jtqq2607229429/my_blancing_car/images/IMG_20210822_150952.jpg

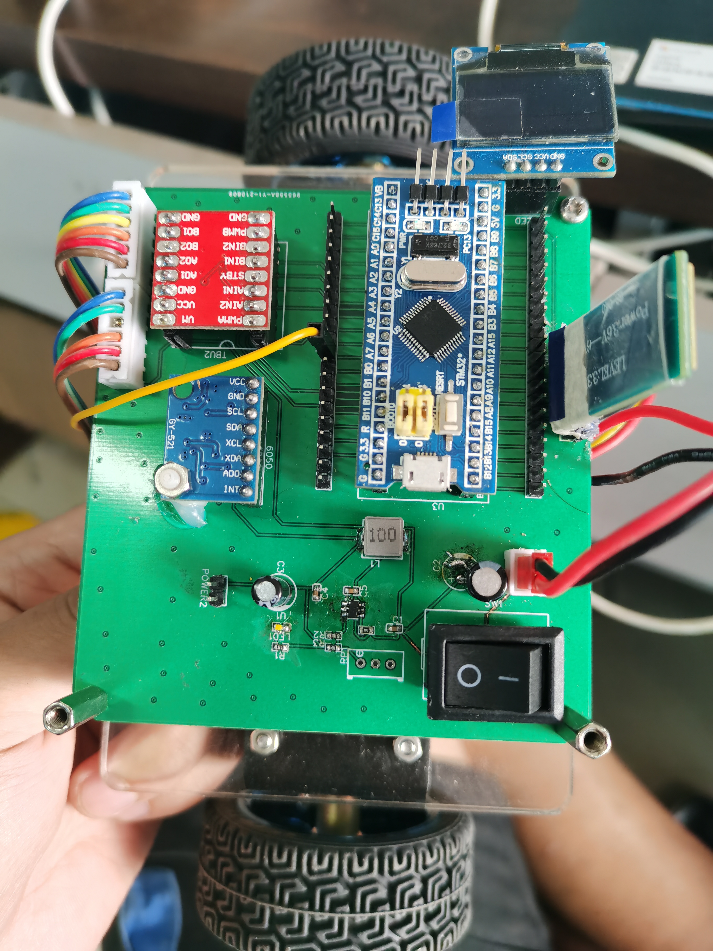
images/IMG_20210822_150952.jpg
