jtqq2607229429/my_blancing_car/Core/Src/main.c

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
/* Includes ------------------------------------------------------------------*/
#include "main.h"
#include "i2c.h"
#include "tim.h"
#include "usart.h"
#include "gpio.h"

/* USER CODE BEGIN Includes */
//#include "oled.h"
#include "hc05.h"
#include "math.h"
#include "mpu6050.h"
#include "oled.h"
#include "pid.h"
#include "stdbool.h"
/* USER CODE END Includes */

/* USER CODE BEGIN PTD */
float kP = 0, kI = 0, kD = 0;
float kP_p = 0, kI_p = 0, kD_p = 0;
float kP_t = 0, kI_t = 0, kD_t = 0;
bool start_flag = false;  //启动
int motor, dir1, dir2 = 0;
extern long rxIndex;
extern int out;
extern int t;
TxPack txpack;
RxPack rxpack;  //蓝牙使用结构体

/* USER CODE END PTD */


void SystemClock_Config(void);
/* USER CODE BEGIN 0 */
//int __io_putchar(int ch) {
//    uint8_t temp[1] = {ch};
//    HAL_UART_Transmit(&huart1, temp, 1, 0xff);
//    return (ch);
//}
/* USER CODE END 0 */

/**
  * @brief  The application entry point.
  * @retval int
  */
int main(void)
{
  /* MCU Configuration--------------------------------------------------------*/

  /* Reset of all peripherals, Initializes the Flash interface and the Systick. */
  HAL_Init();

  /* Configure the system clock */
  SystemClock_Config();

  /* Initialize all configured peripherals */
  MX_GPIO_Init();
  MX_TIM2_Init();
  MX_TIM3_Init();
  MX_USART1_UART_Init();
  MX_TIM4_Init();
  MX_I2C1_Init();
  MX_I2C2_Init();
  MX_TIM1_Init();
  /* USER CODE BEGIN 2 */

    OLED_Init();
    OLED_Clear();
    OLED_ShowString(0, 1, "hollo!", 12);
    OLED_ShowString(0, 2, "kP:", 12);
    OLED_ShowString(0, 3, "kD:", 12);
    OLED_ShowString(0, 4, "kI:", 12);

    HAL_TIM_PWM_Start(&htim2, TIM_CHANNEL_4);  //电机初始化
    HAL_TIM_PWM_Start(&htim2, TIM_CHANNEL_1);  //
    __HAL_TIM_SET_COMPARE(&htim2, TIM_CHANNEL_1, 0);
    __HAL_TIM_SET_COMPARE(&htim2, TIM_CHANNEL_4, 0);

    HAL_TIM_Encoder_Start(&htim3, TIM_CHANNEL_ALL);
    HAL_TIM_Encoder_Start(&htim4, TIM_CHANNEL_ALL);
    __HAL_TIM_SET_COUNTER(&htim3, 5000);
    __HAL_TIM_SET_COUNTER(&htim4, 5000);  // 编码器初始化

    PID_Init(&BC_A_PID, 420, 0, 1.2);
    PID_Init(&BC_P_PID, 550, 2.75, 1.1);                //pid初始化
    PID_Init(&BC_T_PID, -9, 0, -0.8);

    MPU6050_initialize();
    DMP_Init();                                                   //DMP6050初始化

    HAL_Delay(500);                                         //等待6050初始化

    HAL_UART_Receive_IT(&huart1, (uint8_t *) &uartByte, 1);  //蓝牙初始化

    HAL_Delay(200);

    HAL_TIM_Base_Start_IT(&htim1);
   //
  /* USER CODE END 2 */

  /* Infinite loop */
  /* USER CODE BEGIN WHILE */
#pragma clang diagnostic push
#pragma ide diagnostic ignored "EndlessLoop"
    while (1) {
        if (readValuePack(&rxpack)) {          //读蓝牙传输数据
            kP = (float) (rxpack.floats[0]);
            kI = (float) (rxpack.floats[1]);               //这个是第二个速度PID，kP值.
            kD = (float) (rxpack.floats[2]);               //获得pid设定值
            kP_p = (float)(rxpack.floats[3]);
            kD_p = (float) (rxpack.floats[5]);
            kI_p = (float) (rxpack.floats[4]);               //这个是第二个速度PID，kP值.
            kP_t = (float) (rxpack.floats[6]);               //获得pid设定值
            kD_t = (float)(rxpack.floats[8]);
            kI_t = (float)(rxpack.floats[7]);

            motor = rxpack.integers[0];                    //获得速度值
            dir1 = rxpack.integers[1];

            if (rxpack.bools[0]) {                            //将参数存入flash
                save();
            }
            if (rxpack.bytes[0]) {                            //启动
                start_flag = true;
                PID_Init(&BC_A_PID, kP, kI, kD);
                PID_Init(&BC_P_PID, kP_p*200, kP_p, kD);
                PID_Init(&BC_T_PID, kP_t, kI_t, kD_t);
            } else {
                start_flag = false;
            }
        }
        //读蓝牙数据
        txpack.floats[0] = Pitch ;
        txpack.floats[1] = -0.2;
        txpack.floats[2] = Yaw;
        sendValuePack(&txpack);         //蓝牙调试信息

        OLED_ShowNum(36, 2, kP, 12);
        OLED_ShowNum(36, 3, kD, 12);
        OLED_ShowNum(36, 4, kI, 12);
        OLED_ShowNum(36, 5, Pitch, 12);
        OLED_ShowNum(36, 6, rxIndex, 12);
        OLED_ShowNum(36, 7, t, 12);//屏幕显示信息
    /* USER CODE END WHILE */

    /* USER CODE BEGIN 3 */
    }
#pragma clang diagnostic pop
  /* USER CODE END 3 */
}

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
