jtqq2607229429/my_blancing_car/Core/Inc/main.h

#define led_Pin GPIO_PIN_13
#define led_GPIO_Port GPIOC
#define BIN1_Pin GPIO_PIN_1
#define BIN1_GPIO_Port GPIOA
#define BIN2_Pin GPIO_PIN_2
#define BIN2_GPIO_Port GPIOA
#define AIN1_Pin GPIO_PIN_8
#define AIN1_GPIO_Port GPIOA
#define AIN2_Pin GPIO_PIN_11
#define AIN2_GPIO_Port GPIOA
