jtqq2607229429/my_blancing_car/Core/Inc/pid.h

//
// Created by JIANG on 2021/7/9.
//

#ifndef ROTARYINVERTEDPENDULUM_PID_H
#define ROTARYINVERTEDPENDULUM_PID_H

typedef struct pid{
    float err;                //误差
    float err_last;            //前一次误差
    float Kp,Ki,Kd;            //PID计数值
    float out;          //输出
    float integral;            //累计误差
}PID_struct;

extern PID_struct BC_A_PID;
extern PID_struct BC_P_PID;
extern PID_struct BC_T_PID;

void PID_Init(PID_struct *PID,float kp,float ki,float kd);
int PID_calc_A(PID_struct *PID,float e,float g);
int PID_calc_P(PID_struct *PID,int encode);
int PID_calc_T(PID_struct *PID,float z ,float g);
float get_error(float target,float now);
void PID_Clear(PID_struct *PID);


#endif //ROTARYINVERTEDPENDULUM_PID_H
